Polarisru/multiservo/HW/ms_cover.FCStd

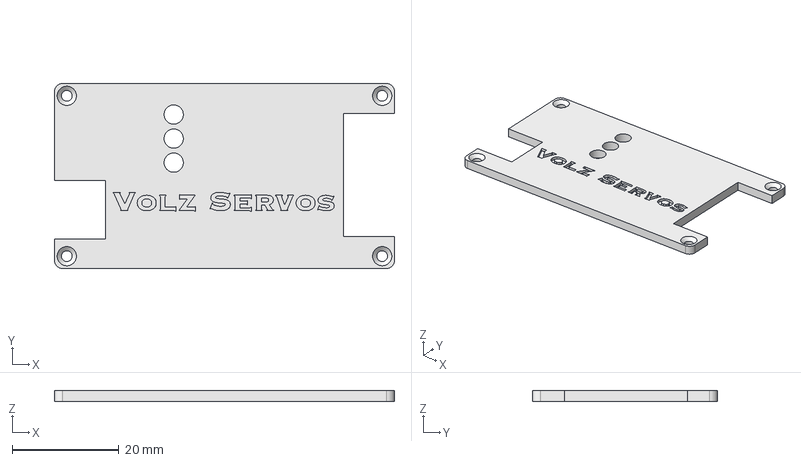
[picture p1: CAD file, 2021-03-29]
HW/ms_cover.FCStd
63.6 x 34.6 x 2.00 mm
