Polarisru/multiservo/HW/ms_bottom_bt.FCStd

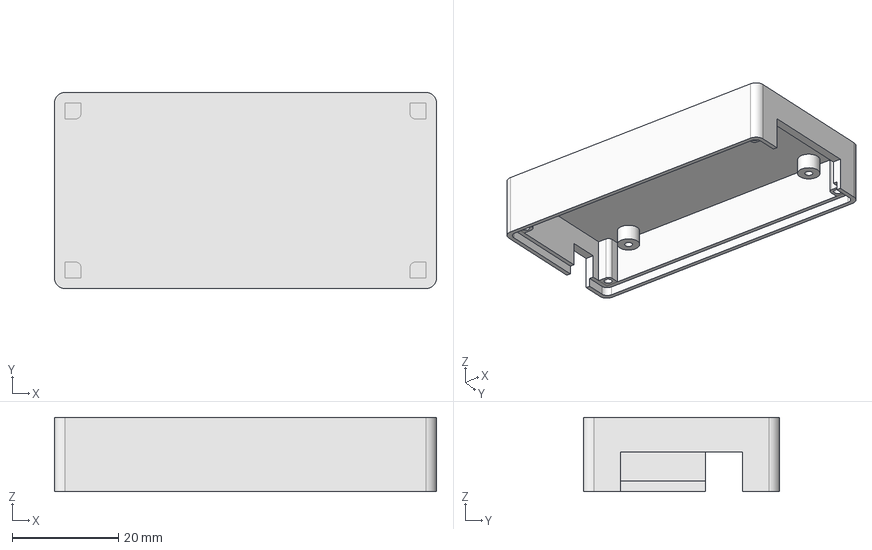
[picture p2: CAD file, 2021-03-03]
HW/ms_bottom_bt.FCStd
72.0 x 37.0 x 14.0 mm
