Polarisru/multiservo/HW/ms_cover_bt.FCStd

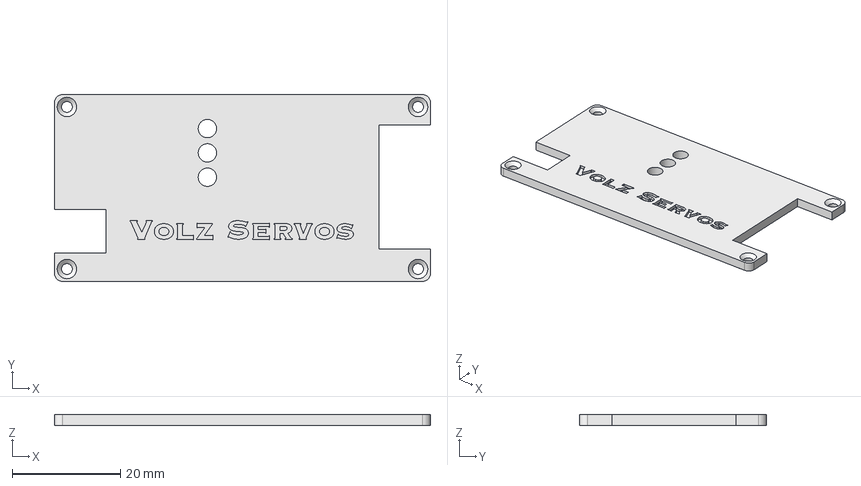
[picture p3: CAD file, 2021-03-03]
HW/ms_cover_bt.FCStd
69.6 x 34.6 x 2.00 mm
