Polarisru/multiservo/HW/ms_bottom.FCStd

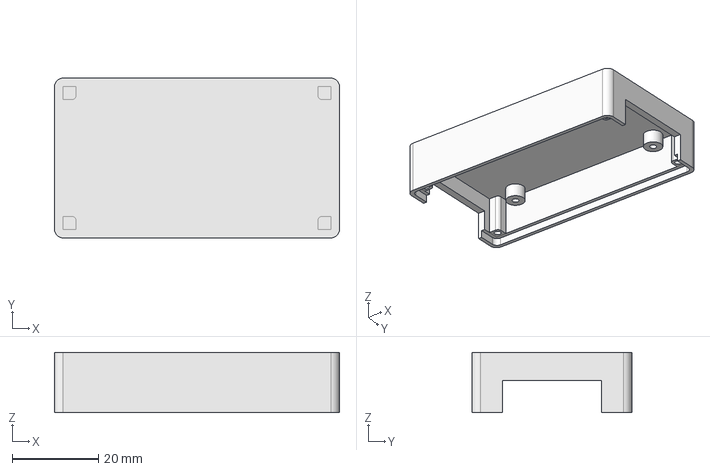
[picture p4: CAD file, 2021-02-24]
HW/ms_bottom.FCStd
66.0 x 37.0 x 14.0 mm
