Polarisru/multiservo/PCB/V3/MultiServo.pdf

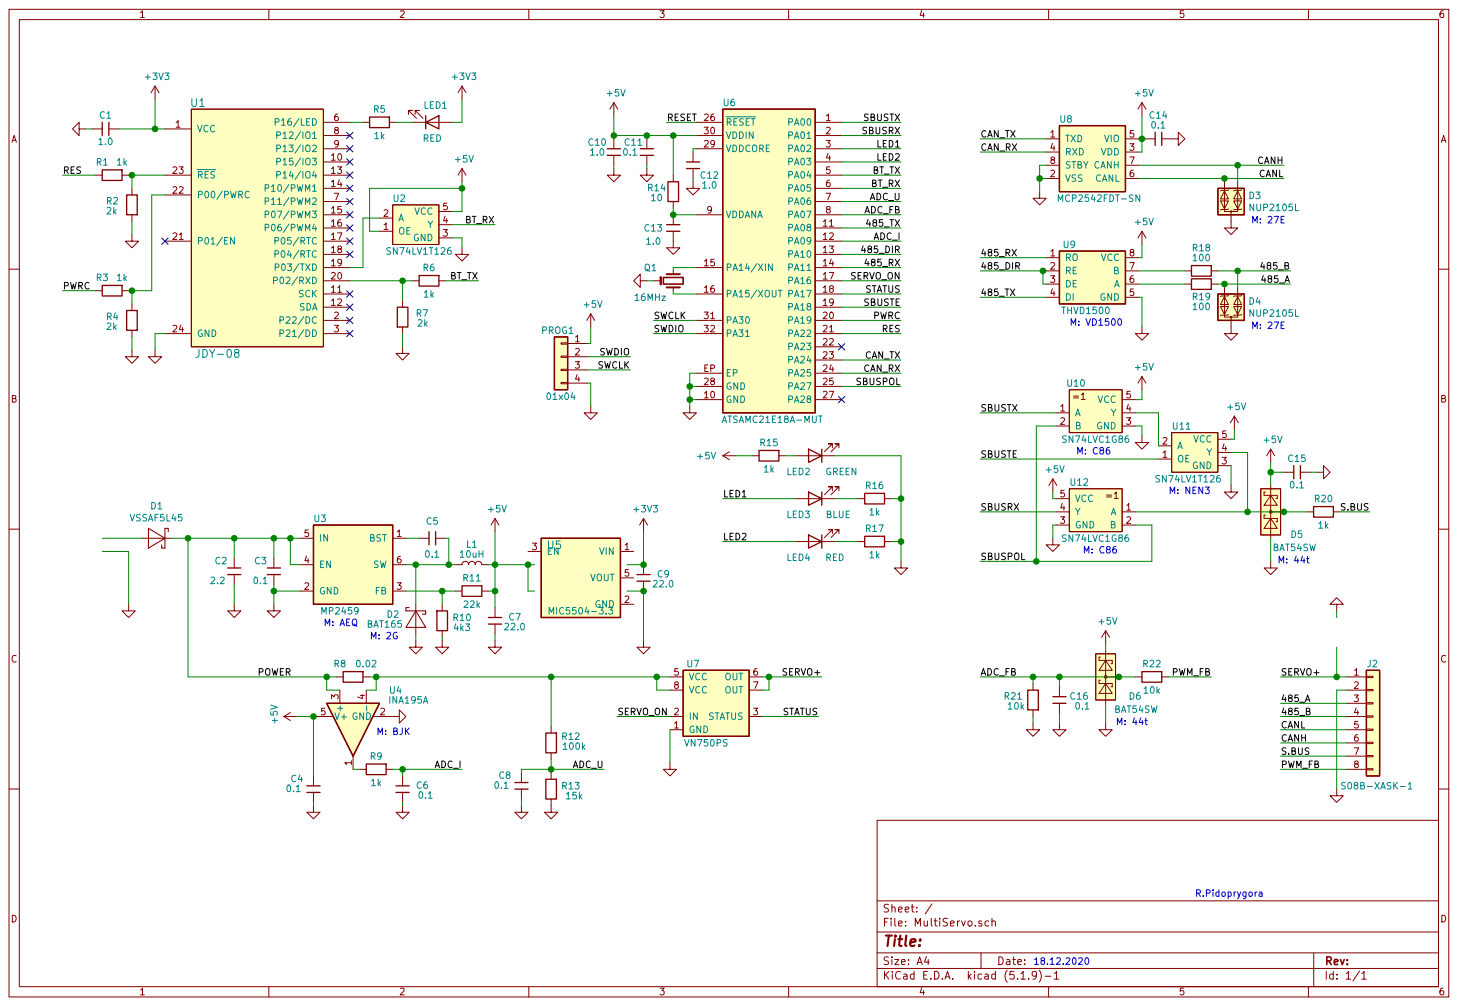
[picture p5: page 1]

Id: 1/1 Title: File: MultiServo.sch Sheet: /
