Polarisru/multiservo/PCB/MultiServo.pdf

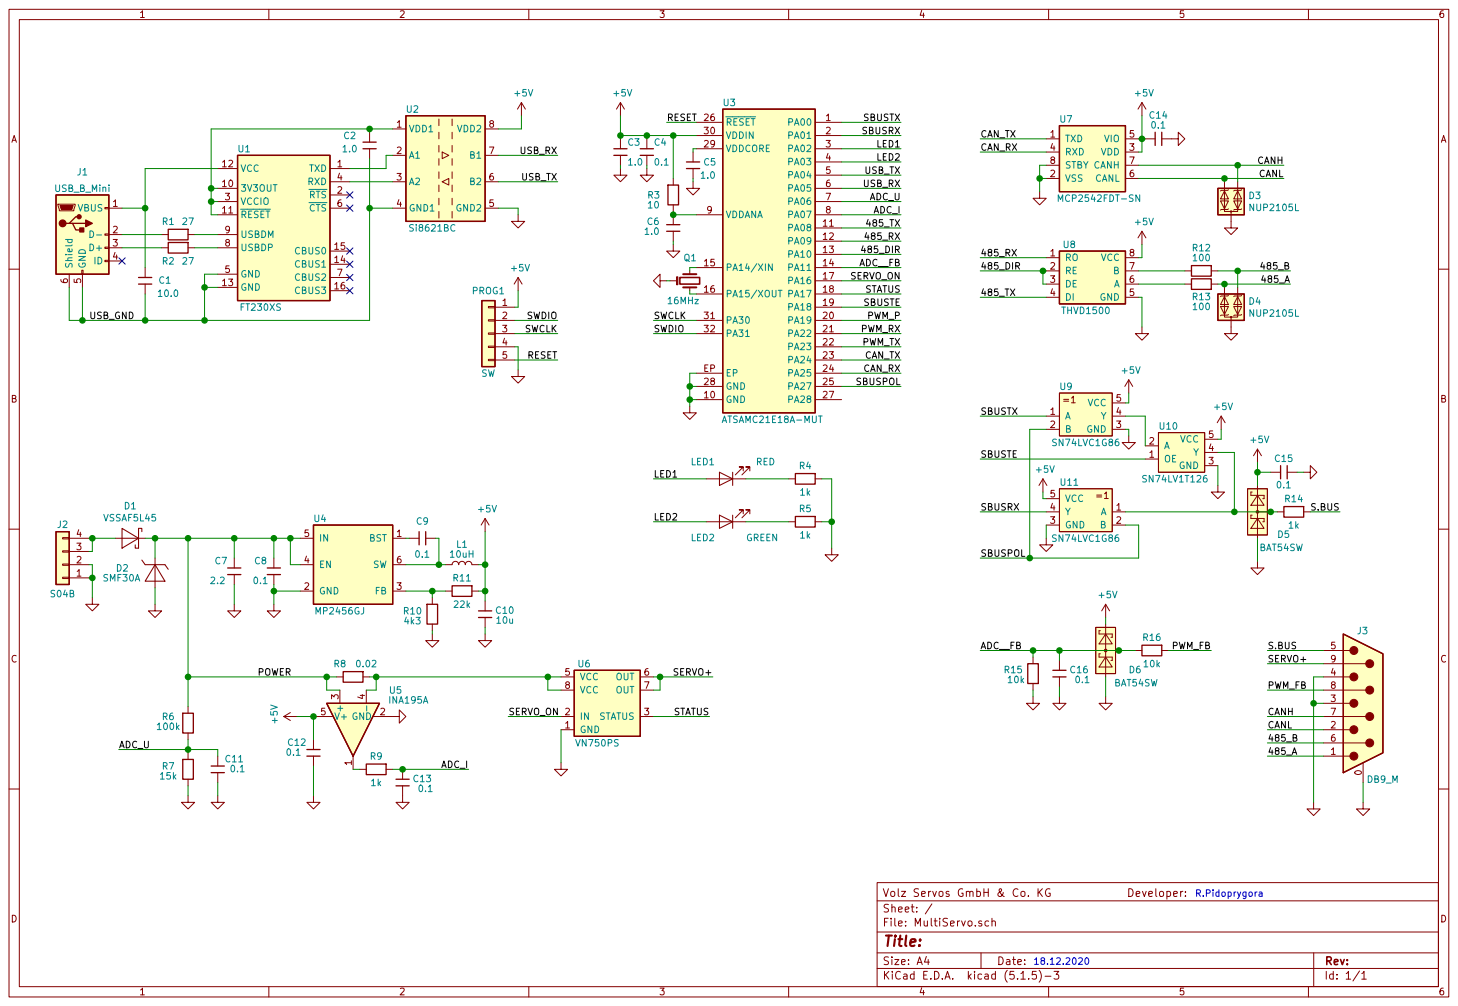
[picture p6: page 1]
