Polarisru/multiservo/PCB/V2/MultiServo.pdf

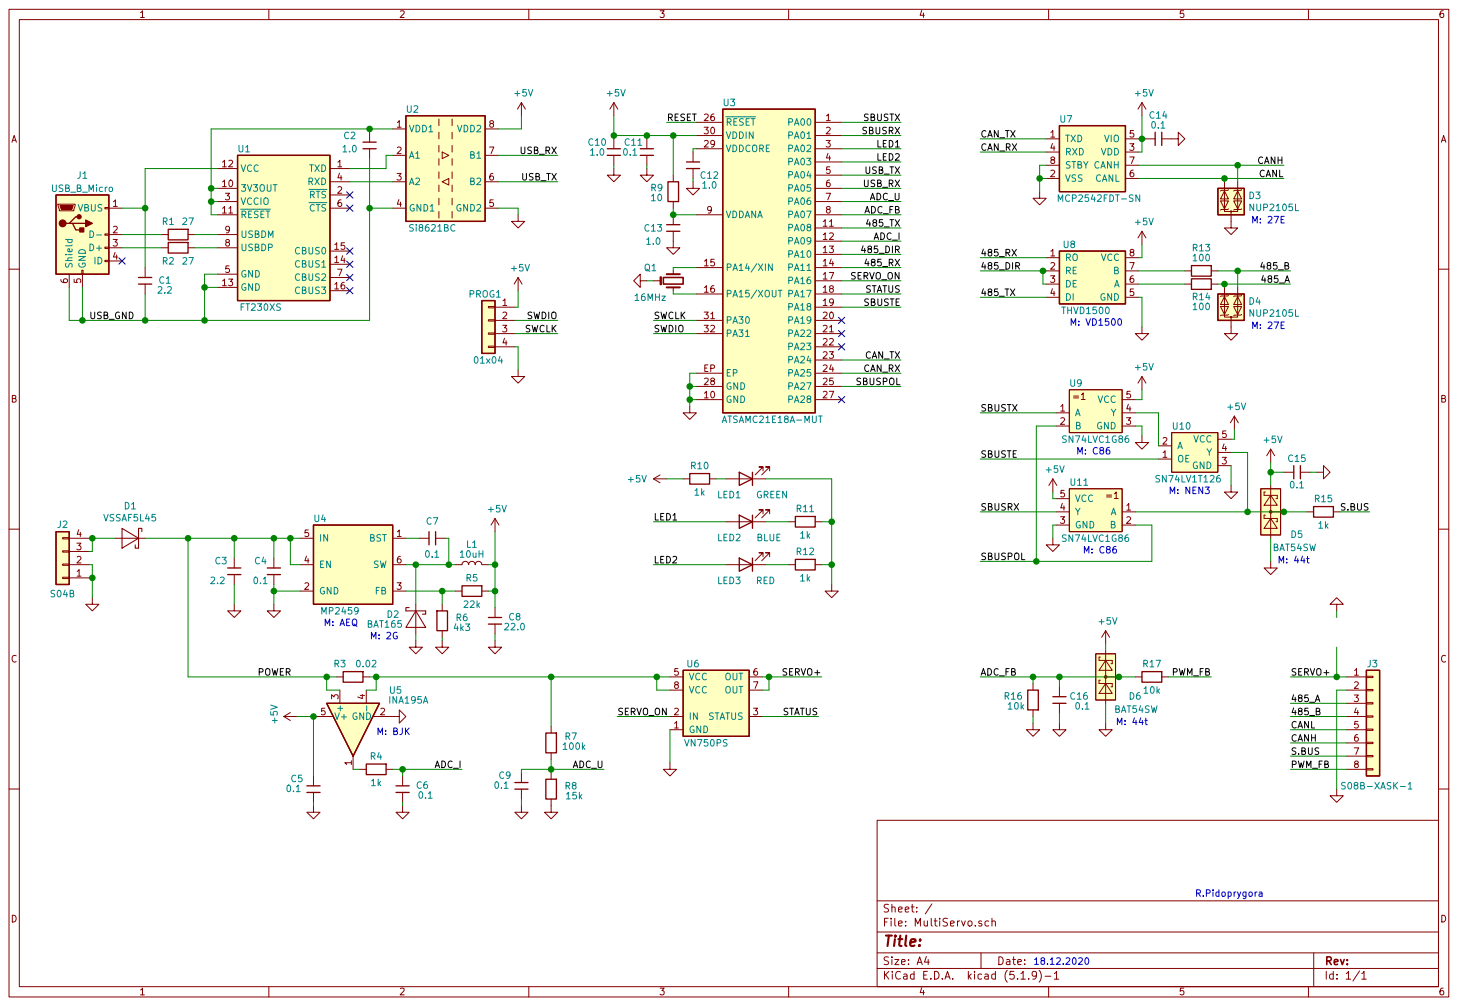
[picture p7: page 1]

Id: 1/1 Title: File: MultiServo.sch Sheet: / R11
