Polarisru/multiservo/PCB/V3/MultiServo.kicad_pcb

## KiCad design PCB/V3/MultiServo.kicad_pcb (2021-01-31)

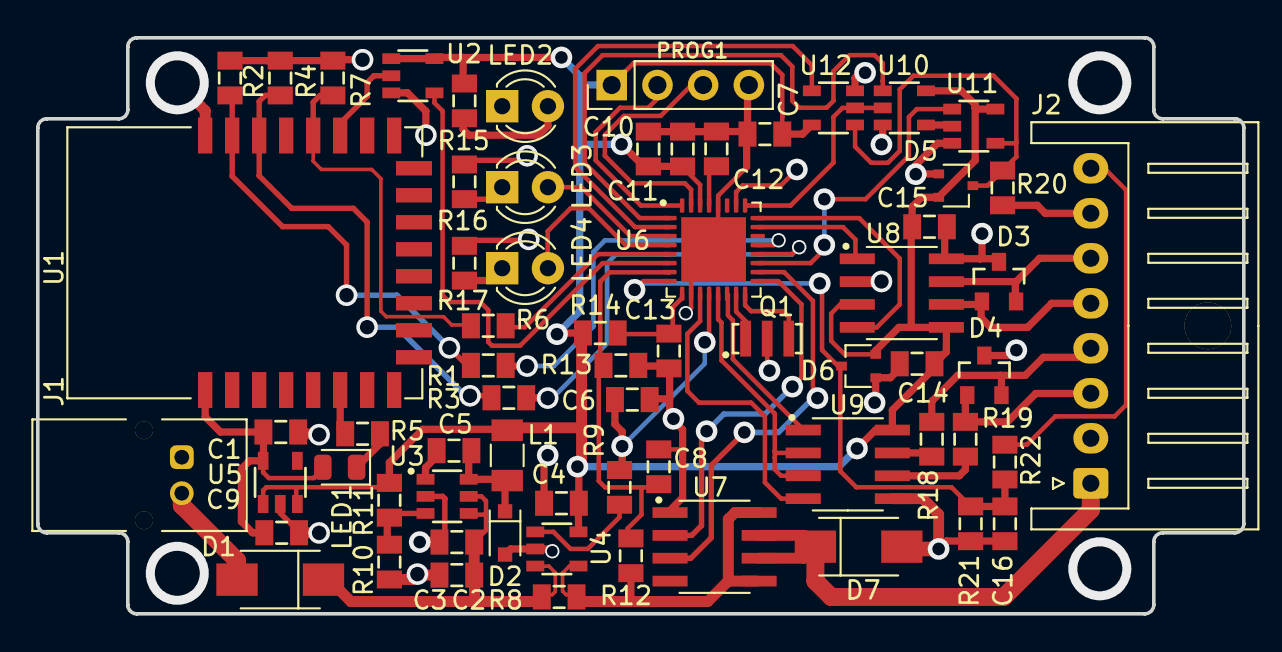
[picture p8: board PCB/V3/MultiServo.kicad_pcb from above]

Board: 2 copper layers, 67.0 x 32.0 mm, 66 parts (0 on the bottom side), 56 nets.

Parts:
C1, C10, C12, C13: 1.0; C0805
C2: 2.2; C0805
C3, C4, C5, C6, C8, C11, C14, C15, C16: 0.1; C0805
C7, C9: 22.0; C0805
D1: VSSAF5L45; D_SMA
D2: BAT165; D_SOD-323
D3, D4: NUP2105L; SOT23-3
D5, D6: BAT54SW; SOT-323_SC-70
D7: SMA6F30A; D_SMA
J1: JST_S02B_PASK; JST_S02B-PASK-2LFSN_1x02
J2: S08B-XASK-1; JST_XA_S08B-XASK-1x08_P2.50mm_Horizontal
L1: 10uH; L_1206
LED1: RED; LED_0805_2012Metric
LED2: GREEN; LED_D3.0mm
LED3: BLUE; LED_D3.0mm
LED4: RED; LED_D3.0mm
PROG1: 01x04; PinHeader_1x04_P2.54mm_Vertical
Q1: 16MHz; RES-3
R1, R3, R5, R6, R9, R15, R16, R17, R20: 1k; R0805
R2, R4, R7: 2k; R0805
R8: 0.02; R0805
R10: 4k3; R0805
R11: 22k; R0805
R12: 100k; R0805
R13: 15k; R0805
R14: 10; R0805
R18, R19: 100; R0805
R21, R22: 10k; R0805
U1: JDY-08
U2, U11: SN74LV1T126; SOT23-5
U3: MP2459; SOT23-6
U4: INA195A; SOT23-5
U5: MIC5504-3.3; SOT23-5
U6: ATSAMC21E18A-MUT; QFN-32-1EP_5x5mm_P0.5mm_EP3.6x3.6mm
U7: VN750PS; SOIC-8_3.9x4.9mm_P1.27mm
U8: MCP2542FDT-SN; SOIC-8_3.9x4.9mm_P1.27mm
U9: THVD1500; SOIC-8_3.9x4.9mm_P1.27mm
U10, U12: SN74LVC1G86; SOT23-5

Connections:
+3V3: C1.1, C9.2, LED1.2, U1.1, U5.5
+5V: C4.2, C7.2, C10.1, C11.1, C14.1, C15.1, D5.2, D6.2, L1.2, PROG1.1, R11.1, R14.2, R15.2, U2.1, U2.5, U4.5, U5.1, U5.3, U6.30, U8.3, U8.5, U9.8, U10.5, U11.5, U12.5
/485_A: D4.1, J2.3, R19.1
/485_B: D4.2, J2.4, R18.1
/485_DIR: U6.13, U9.2, U9.3
/485_RX: U6.14, U9.1
/485_TX: U6.11, U9.4
/ADC_FB: C16.2, D6.3, R21.2, R22.2, U6.8
/ADC_I: C6.2, R9.1, U6.12
/ADC_U: C8.2, R12.2, R13.1, U6.7
/BT_RX: U2.4, U6.6
/BT_TX: R6.1, U6.5
/CANH: D3.2, J2.6, U8.7
/CANL: D3.1, J2.5, U8.6
/CAN_RX: U6.24, U8.4
/CAN_TX: U6.23, U8.1
/LED1: LED3.2, U6.3
/LED2: LED4.2, U6.4
/POWER: C2.2, C3.2, D1.1, R8.2, U3.4, U3.5, U4.3
/PWM_FB: J2.8, R22.1
/PWRC: R3.2, U6.20
/RES: R1.2, U6.21
/S.BUS: J2.7, R20.1
/SBUSPOL: U6.25, U10.2, U12.2
/SBUSRX: U6.2, U12.4
/SBUSTE: U6.19, U11.1
/SBUSTX: U6.1, U10.1
/SERVO+: D7.1, J2.1, U7.6, U7.7
/SERVO_ON: U6.17, U7.2
/STATUS: U6.18, U7.3
/SWCLK: PROG1.3, U6.31
/SWDIO: PROG1.2, U6.32
GND: C1.2, C2.1, C3.1, C4.1, C6.1, C7.1, C8.1, C9.1, C10.2, C11.2, C12.2, C13.2, C14.2, C15.2, C16.1, D2.2, D3.3, D4.3, D5.1, D6.1, D7.2, J1.1, J2.2, LED2.1, PROG1.4, Q1.2, R2.1, R4.1, R7.1, R10.2, R13.2, R16.1, R17.1, R21.1, U1.24, U2.3, U3.2, U4.2, U5.2, U6.10, U6.28, U6.EP, U7.1, U8.2, U8.8, U9.5, U10.3, U11.3, U12.3
unnamed: C5.1, U3.1
unnamed: C5.2, D2.1, L1.1, U3.6
unnamed: C12.1, U6.29
unnamed: C13.1, R14.1, U6.9
unnamed: D1.2, J1.2
unnamed: D5.3, R20.2, U11.4, U12.1
unnamed: LED1.1, R5.1
unnamed: LED2.2, R15.1
unnamed: LED3.1, R16.2
unnamed: LED4.1, R17.2
unnamed: Q1.1, U6.15
unnamed: Q1.3, U6.16
unnamed: R1.1, R2.2, U1.23
unnamed: R3.1, R4.2, U1.22
unnamed: R5.2, U1.6
unnamed: R6.2, R7.2, U1.20
unnamed: R9.2, U4.1
unnamed: R10.1, R11.2, U3.3
unnamed: R8.1, R12.1, U4.4, U7.5, U7.8
unnamed: R18.2, U9.7
unnamed: R19.2, U9.6
unnamed: U1.19, U2.2
unnamed: U10.4, U11.2
