Polarisru/multiservo/PCB/V2/MultiServo.kicad_pcb

## KiCad design PCB/V2/MultiServo.kicad_pcb (2021-01-31, an earlier design)

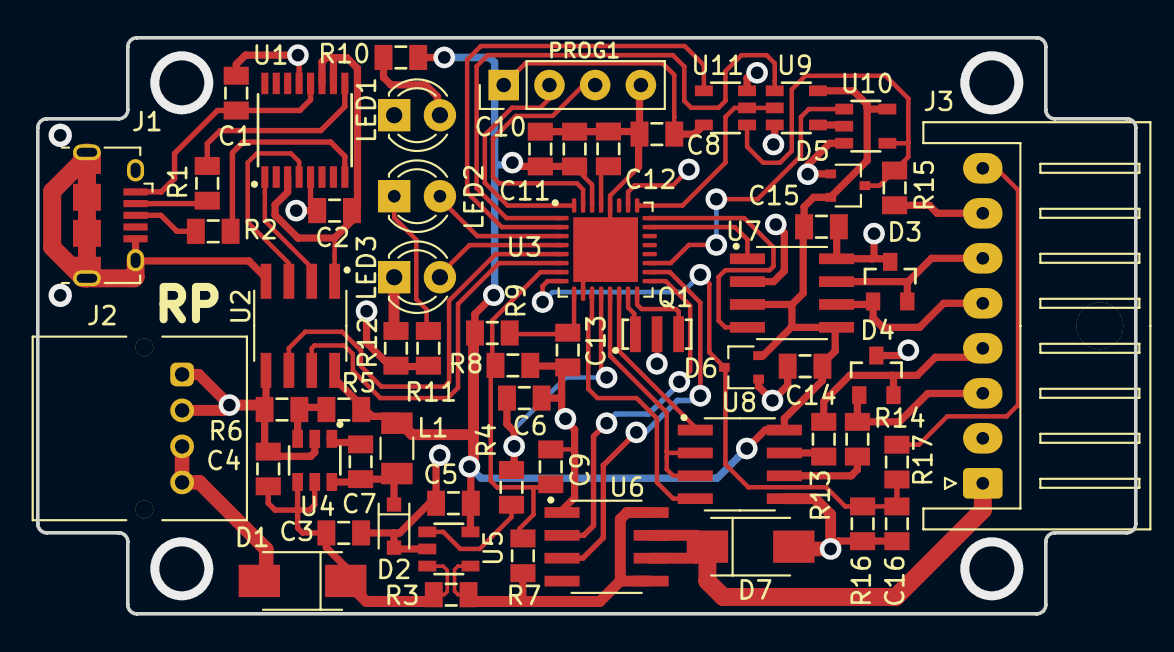
[picture p9: board PCB/V2/MultiServo.kicad_pcb from above]

Board: 2 copper layers, 61.0 x 32.0 mm, 60 parts (0 on the bottom side), 56 nets.

Parts:
C1, C3: 2.2; C0805
C2, C10, C12, C13: 1.0; C0805
C4, C5, C6, C7, C9, C11, C14, C15, C16: 0.1; C0805
C8: 22.0; C0805
D1: VSSAF5L45; D_SMA
D2: BAT165; D_SOD-323
D3, D4: NUP2105L; SOT23-3
D5, D6: BAT54SW; SOT-323_SC-70
D7: SMA6F30A; D_SMA
J1: USB_B_Micro; USB_Micro-B_Amphenol_10118194_Horizontal
J2: S04B; JST_S04B-PASK-2LFSN_1x04
J3: S08B-XASK-1; JST_XA_S08B-XASK-1x08_P2.50mm_Horizontal
L1: 10uH; L_1206
LED1: GREEN; LED_D3.0mm
LED2: BLUE; LED_D3.0mm
LED3: RED; LED_D3.0mm
PROG1: 01x04; PinHeader_1x04_P2.54mm_Vertical
Q1: 16MHz; RES-3
R1, R2: 27; R0805
R3: 0.02; R0805
R4, R10, R11, R12, R15: 1k; R0805
R5: 22k; R0805
R6: 4k3; R0805
R7: 100k; R0805
R8: 15k; R0805
R9: 10; R0805
R13, R14: 100; R0805
R16, R17: 10k; R0805
U1: FT230XS; SSOP-16_3.9x4.9mm_P0.635mm
U2: Si8621BC; SOIC-8_3.9x4.9mm_P1.27mm
U3: ATSAMC21E18A-MUT; QFN-32-1EP_5x5mm_P0.5mm_EP3.6x3.6mm
U4: MP2459; SOT23-6
U5: INA195A; SOT23-5
U6: VN750PS; SOIC-8_3.9x4.9mm_P1.27mm
U7: MCP2542FDT-SN; SOIC-8_3.9x4.9mm_P1.27mm
U8: THVD1500; SOIC-8_3.9x4.9mm_P1.27mm
U9, U11: SN74LVC1G86; SOT23-5
U10: SN74LV1T126; SOT23-5

Connections:
+5V: C5.2, C8.2, C10.1, C11.1, C14.1, C15.1, D5.2, D6.2, L1.2, PROG1.1, R5.1, R9.2, R10.2, U2.8, U3.30, U5.5, U7.3, U7.5, U8.8, U9.5, U10.5, U11.5
/485_A: D4.1, J3.3, R14.1
/485_B: D4.2, J3.4, R13.1
/485_DIR: U3.13, U8.2, U8.3
/485_RX: U3.14, U8.1
/485_TX: U3.11, U8.4
/ADC_FB: C16.2, D6.3, R16.2, R17.2, U3.8
/ADC_I: C6.2, R4.1, U3.12
/ADC_U: C9.2, R7.2, R8.1, U3.7
/CANH: D3.2, J3.6, U7.7
/CANL: D3.1, J3.5, U7.6
/CAN_RX: U3.24, U7.4
/CAN_TX: U3.23, U7.1
/LED1: LED2.2, U3.3
/LED2: LED3.2, U3.4
/POWER: C3.2, C4.2, D1.1, R3.2, U4.4, U4.5, U5.3
/PWM_FB: J3.8, R17.1
/S.BUS: J3.7, R15.1
/SBUSPOL: U3.25, U9.2, U11.2
/SBUSRX: U3.2, U11.4
/SBUSTE: U3.19, U10.1
/SBUSTX: U3.1, U9.1
/SERVO+: D7.1, J3.1, U6.6, U6.7
/SERVO_ON: U3.17, U6.2
/STATUS: U3.18, U6.3
/SWCLK: PROG1.3, U3.31
/SWDIO: PROG1.2, U3.32
/USB_GND: C1.1, C2.2, J1.5, J1.6, U1.5, U1.13, U2.4
/USB_RX: U2.7, U3.6
/USB_TX: U2.6, U3.5
GND: C3.1, C4.1, C5.1, C6.1, C8.1, C9.1, C10.2, C11.2, C12.2, C13.2, C14.2, C15.2, C16.1, D2.2, D3.3, D4.3, D5.1, D6.1, D7.2, J2.1, J2.2, J3.2, LED1.1, PROG1.4, Q1.2, R6.2, R8.2, R11.1, R12.1, R16.1, U2.5, U3.10, U3.28, U3.EP, U4.2, U5.2, U6.1, U7.2, U7.8, U8.5, U9.3, U10.3, U11.3
unnamed: C1.2, J1.1, U1.12
unnamed: C2.1, U1.3, U1.10, U1.11, U2.1
unnamed: C7.1, U4.1
unnamed: C7.2, D2.1, L1.1, U4.6
unnamed: C12.1, U3.29
unnamed: C13.1, R9.1, U3.9
unnamed: D1.2, J2.3, J2.4
unnamed: D5.3, R15.2, U10.4, U11.1
unnamed: J1.2, R1.2
unnamed: J1.3, R2.2
unnamed: LED1.2, R10.1
unnamed: LED2.1, R11.2
unnamed: LED3.1, R12.2
unnamed: Q1.1, U3.15
unnamed: Q1.3, U3.16
unnamed: R1.1, U1.9
unnamed: R2.1, U1.8
unnamed: R3.1, R7.1, U5.4, U6.5, U6.8
unnamed: R4.2, U5.1
unnamed: R5.2, R6.1, U4.3
unnamed: R13.2, U8.7
unnamed: R14.2, U8.6
unnamed: U1.1, U2.2
unnamed: U1.4, U2.3
unnamed: U9.4, U10.2
