Polarisru/multiservo/FW/src/drivers.h

#ifndef DRIVERS_H
#define DRIVERS_H

#ifndef DEF_UNITTEST
  #include "driver_adc.h"
  #include "driver_can.h"
  #include "driver_clk.h"
  #include "driver_dma.h"
  #include "driver_flash.h"
  #include "driver_gpio.h"
  #include "driver_pwm.h"
  #include "driver_temp.h"
  #include "driver_uart.h"
  #include "driver_vref.h"
  #include "driver_wdt.h"
#endif

#endif
