Polarisru/multiservo/FW/src/actions.c

#include "actions.h"
#include "analog.h"
#include "canbus.h"
#include "canbus_volz.h"
#include "canbus_amazon.h"
#include "canbus_meteor.h"
#include "conversion.h"
#include "global.h"
#include "keeloq.h"
#include "pwmout.h"
#include "rs485comm.h"
#include "sbus.h"

/** \brief Move servo to position
 *
 * \param [in] pos Position to move
 * \return True if action succeed
 *
 */
bool ACTIONS_MoveToPosition(float pos)
{
  bool res = true;

  switch (GLOBAL_ConnMode)
  {
    case CONN_MODE_PWM:
      PWMOUT_SetValue(pos);
      break;
    case CONN_MODE_RS485:
      res = RS485COMM_SetPosition(pos);
      break;
    case CONN_MODE_CAN:
      res = CANBUS_SetPosition(pos);
      break;
    case CONN_MODE_AMAZON:
      res = CANBUS_SetPositionAmazon(pos);
      break;
    case CONN_MODE_SBUS:
      res = SBUS_SetPosition(pos);
      break;
    case CONN_MODE_METEOR:
      return CANBUS_SetPositionMeteor(pos);
    default:
      return false;
  }

  if (res == true)
    /**< Start fast current measurement */
    ANALOG_StartDMA();
  return res;
}

bool ACTIONS_GetPosition(float *pos)
{
  switch (GLOBAL_ConnMode)
  {
    case CONN_MODE_PWM:
      /**< Get feedback voltage */
      *pos = CONVERSION_GetFeedbackPos();
      return true;
    case CONN_MODE_RS485:
      return RS485COMM_GetPosition(pos);
    case CONN_MODE_CAN:
      return CANBUS_GetPosition(pos);
    case CONN_MODE_AMAZON:
      return CANBUS_GetPositionAmazon(pos);
    case CONN_MODE_SBUS:
      break;
    case CONN_MODE_METEOR:
      return CANBUS_GetPositionMeteor(pos);
  }

  return false;
}

/** \brief Read byte from servo
 *
 * \param [in] addr Address to read from
 * \param [out] value Pointer fo readout value
 * \return True if succeed
 *
 */
bool ACTIONS_ReadByte(uint16_t addr, uint8_t *value)
{
  switch (GLOBAL_ConnMode)
  {
    case CONN_MODE_PWM:
      return KEELOQ_Read(addr, value);
    case CONN_MODE_RS485:
      return RS485COMM_ReadByte(addr, value);
    case CONN_MODE_CAN:
      return CANBUS_ReadByte(addr, value);
    case CONN_MODE_AMAZON:
      break;
    case CONN_MODE_SBUS:
      break;
    case CONN_MODE_METEOR:
      return CANBUS_ReadByteMeteor(addr, value);
  }

  return false;
}

bool ACTIONS_WriteByte(uint16_t addr, uint8_t value)
{
  switch (GLOBAL_ConnMode)
  {
    case CONN_MODE_PWM:
      return KEELOQ_Write(addr, value);
    case CONN_MODE_RS485:
      return RS485COMM_WriteByte(addr, value);
    case CONN_MODE_CAN:
      return CANBUS_WriteByte(addr, value);
    case CONN_MODE_AMAZON:
      break;
    case CONN_MODE_SBUS:
      break;
    case CONN_MODE_METEOR:
      return CANBUS_WriteByteMeteor(addr, value);
  }

  return false;
}

/** \brief Read device parameter
 *
 * \param param Id of the parameter
 * \param val Pointer to uint8_t to store result
 * \return True if success
 *
 */
bool ACTION_ReadParameter(uint8_t param, uint8_t *val)
{
  uint8_t temp;
  bool result;

  if (param >= ACTION_PARAM_LAST)
    return false;

  switch (GLOBAL_ConnMode)
  {
    case CONN_MODE_PWM:
      switch (param)
      {
        case ACTION_PARAM_CURRENT:
          temp = KEELOQ_ADDR_CURRENT;
          break;
        case ACTION_PARAM_VOLTAGE:
          temp = KEELOQ_ADDR_VOLTAGE;
          break;
        case ACTION_PARAM_TEMPERATURE:
          temp = KEELOQ_ADDR_TEMP;
          break;
        default:
          return false;
      }
      //PWM_DisableChannel(PWM_CH1);
      result = KEELOQ_Read(temp, val);
      //PWM_EnableChannel(PWM_CH1);
      if (*val == 0xff)
        return false;
      return result;

    case CONN_MODE_RS485:
      switch (param)
      {
        case ACTION_PARAM_CURRENT:
          return RS485COMM_GetCurrent(val);
        case ACTION_PARAM_VOLTAGE:
          return RS485COMM_GetVoltage(val);
        case ACTION_PARAM_TEMPERATURE:
          return RS485COMM_GetTemperature(val);
      }

    case CONN_MODE_CAN:
      switch (param)
      {
        case ACTION_PARAM_CURRENT:
          return CANBUS_GetCurrent(val);
        case ACTION_PARAM_VOLTAGE:
          return CANBUS_GetVoltage(val);
        case ACTION_PARAM_TEMPERATURE:
          return CANBUS_GetTemperature(val);
      }

    case CONN_MODE_AMAZON:
      switch (param)
      {
        case ACTION_PARAM_CURRENT:
          return CANBUS_GetCurrentAmazon(val);
        case ACTION_PARAM_VOLTAGE:
          return CANBUS_GetVoltageAmazon(val);
        case ACTION_PARAM_TEMPERATURE:
          return CANBUS_GetTemperatureAmazon(val);
          break;
      }
      return true;
  }

  return false;
}

/** \brief Set bus ID for selected protocol
 *
 * \param id ID to set
 * \return True if success
 *
 */
bool ACTIONS_SetId(uint8_t id)
{
  switch (GLOBAL_ConnMode)
  {
    case CONN_MODE_PWM:
      return false;
    case CONN_MODE_RS485:
      return true;
    case CONN_MODE_CAN:
      return CANBUS_SetId(id);
    case CONN_MODE_AMAZON:
      return true;
    case CONN_MODE_UAVCAN_0:
      return true;
    case CONN_MODE_SBUS:
      return true;
      break;
    case CONN_MODE_METEOR:
      return true;
    default:
      return false;
  }
}

/** \brief Set working mode (PWM/RS485/CAN/SBUS)
 *
 * \param [in] mode Working mode
 * \return True if succeed
 *
 */
bool ACTIONS_SetMode(uint8_t mode)
{
  if (mode >= CONN_MODE_LAST)
    return false;

  PWMOUT_Disable();
  SBUS_Disable();

  GLOBAL_ConnMode = mode;
  switch (mode)
  {
    case CONN_MODE_PWM:
      PWMOUT_Enable();
      break;
    case CONN_MODE_RS485:
      /**< Do nothing, is always working */
      break;
    case CONN_MODE_CAN:
      break;
    case CONN_MODE_AMAZON:
      break;
    case CONN_MODE_UAVCAN_0:
      /**< Have to start Node allocation server here */
      break;
    case CONN_MODE_SBUS:
      SBUS_Enable();
      break;
    case CONN_MODE_METEOR:
      break;
  }

  return true;
}
