Polarisru/multiservo/FW/src/canbus.c

#include <string.h>
#include "canbus.h"
#include "defines.h"
#include "global.h"

#define CAN_PORT            GPIO_PORTA
#define CAN_PIN_RX          25
#define CAN_PIN_TX          24

#define CAN_MUX_RX          MUX_PA25G_CAN0_RX
#define CAN_MUX_TX          MUX_PA24G_CAN0_TX

#define CAN_CHANNEL         CAN0
#define CAN_INTHANDLER      CAN0_Handler
#define CAN_IRQ             CAN0_IRQn

///**< The queue is to be created to hold a maximum of 10 uint64_t variables */
//#define CAN_QUEUE_LENGTH    10
//#define CAN_ITEM_SIZE       sizeof(TCanMsg)
//
//QueueHandle_t xQueueCAN;

TCanMsg rxMsg;

/**< CAN interrupt handler */
void CAN_INTHANDLER(void)
{
  uint32_t ir;
  BaseType_t xHigherPriorityTaskWoken = pdFALSE;

  ir = CAN_CHANNEL->IR.reg;

  if (ir & CAN_IR_RF0N)
  {
    struct can_message msg;
    uint8_t data[64];

    msg.data = data;
    CAN_ReadMsg(CAN_CHANNEL, &msg);
    rxMsg.id = msg.id;
    rxMsg.fmt = msg.fmt;
    rxMsg.len = msg.len;
    memcpy(rxMsg.data, msg.data, msg.len);
    //xQueueSendFromISR(xQueueCAN, &CanMsg, &xHigherPriorityTaskWoken);
    xEventGroupSetBitsFromISR(xEventGroupCommon, EG_BIT_CAN_RX, &xHigherPriorityTaskWoken);
  }

	CAN_CHANNEL->IR.reg = ir;

  /**< Now the buffer is empty we can switch context if necessary */
  portYIELD_FROM_ISR(xHigherPriorityTaskWoken);
}

/** \brief Send one CAN message
 *
 * \param [in] msg Pointer to CANFDMessage to send
 * \param [in] ext Extended CAN ID: true
 * \param [in] fd  CANFD message: true
 * \param [in] brs Message with baudrate switching: true
 * \return True if succeed
 *
 */
bool CANBUS_SendMessage(uint32_t id, uint8_t *data, uint8_t datalen, bool ext, bool fd, bool brs)
{
  struct can_message msg;

  msg.id = id;
  msg.type = CAN_TYPE_DATA;
  msg.data = data;
  msg.len = datalen;
  if (ext == true)
    msg.fmt  = CAN_FMT_EXTID;
  else
    msg.fmt = CAN_FMT_STDID;
  if (fd == true)
    msg.type = CAN_TYPE_FD;
  else
    msg.type = CAN_TYPE_DATA;
  if (brs == true)
    msg.type = CAN_TYPE_FD_BRS;
  return (CAN_WriteMsg(CAN_CHANNEL, &msg) == ERR_NONE);
}

/** \brief Receive one message from CAN bus
 *
 * \param [out] msg Pointer to received CANFDMessage
 * \return True if succeed
 *
 */
bool CANBUS_ReceiveMessage(TCanMsg *msg)
{
  EventBits_t uxBits = 0;

  uxBits = xEventGroupWaitBits(xEventGroupCommon, EG_BIT_CAN_RX, pdTRUE, pdFALSE, 1);
  if ((uxBits & EG_BIT_CAN_RX) == EG_BIT_CAN_RX)
  {
    memcpy(msg, &rxMsg, sizeof(TCanMsg));
    return true;
  }

  return false;
}

/** \brief Set CAN baudrate
 *
 * \param [in] nominal_br New nominal baudrate value
 * \param [in] data_br New data baudrate value (CAN FD only)
 * \return bool True if succeed
 *
 */
bool CANBUS_SetBaudrate(uint32_t nominal_br, uint32_t data_br)
{
  return CAN_SetBaudrate(CAN_CHANNEL, nominal_br, data_br);
}

/** \brief Deinitialize CAN module
 *
 * \return Nothing
 *
 */
void CANBUS_Disable(void)
{
  CAN_Disable(CAN_CHANNEL);
}

/** \brief Initialize CAN communication module
 *
 * \return Nothing
 *
 */
void CANBUS_Configuration(void)
{
  CAN_Init(CAN_CHANNEL);

  /**< Enable CAN interrupt */
  NVIC_DisableIRQ(CAN_IRQ);
  NVIC_ClearPendingIRQ(CAN_IRQ);
  NVIC_EnableIRQ(CAN_IRQ);
  CAN_CHANNEL->ILE.reg = CAN_ILE_EINT0;

  /**< Configure CAN pins */
  /**< There is only one available pin configuration for this MCU */
  GPIO_SetFunction(CAN_PORT, CAN_PIN_TX, CAN_MUX_TX);
  GPIO_SetFunction(CAN_PORT, CAN_PIN_RX, CAN_MUX_RX);

  /**< Setup CAN filters */
	//CAN_SetRangeFilter(0, CAN_FMT_EXTID, CANBUS_NOC_FILTER, CANBUS_NOC_FILTER + CANBUS_SERVO_MAX_ID);
	//CAN_SetRangeFilter(1, CAN_FMT_EXTID, CANBUS_TMC_FILTER, CANBUS_TMC_FILTER + CANBUS_SERVO_MAX_ID);
	CAN_SetRangeFilter(0, CAN_FMT_STDID, 0x000, 0x7ff);

	CAN_Enable(CAN_CHANNEL);
}
