Polarisru/multiservo/FW/src/analog.h

#ifndef ADC_H
#define ADC_H

#include "defines.h"

#define ADC_REF_VOLTAGE     4.096f

#define ADC_MAX_VALUE       4096

#define FB_VOLTAGE_ZERO     2.5f

enum {
  ADC_CHANNEL_U,
  ADC_CHANNEL_FB,
  ADC_CHANNEL_I,
  ADC_CHANNEL_NUM
};

typedef struct {
  uint8_t port;
  uint8_t pin;
  uint8_t pin_mode;
  uint8_t channel;
} TAnalogChannel;

uint16_t ANALOG_GetValueADC0(uint8_t channel);
uint16_t ANALOG_GetValueADC1(uint8_t channel, uint8_t type);
void ANALOG_StartDMA(void);
uint16_t ANALOG_GetSpikeValue(void);
bool ANALOG_GetBuff(uint32_t num, uint8_t *data);
void ANALOG_FillFftBuff(int8_t *data, uint16_t len);
void ANALOG_Configuration(void);

#endif
