Polarisru/multiservo/FW/src/global.c

#include "global.h"

/**< List of global variables */
uint32_t GLOBAL_Baudrate;
uint8_t  GLOBAL_ConnMode;
float    GLOBAL_PeakCurrent;
bool     GLOBAL_PowerOn;

/**< EEPROM variables with default values */
int16_t  EE_CurrOffset;
float    EE_VoltSupplyDiv;

TaskHandle_t xTaskComm;
TaskHandle_t xTaskSbus;

EventGroupHandle_t xEventGroupCommon;
