Polarisru/multiservo/FW/src/utils.c

#include <ctype.h>
#include <string.h>
#include "utils.h"

/** \brief Make string value for the binary number
 *
 * \param [in] value Integer value to convert to binary string
 * \param [in] len Length of binary number
 * \return String with binary value
 *
 */
const char *UTILS_Int2Bin(uint32_t value, uint8_t len)
{
  static char b[32];
  uint32_t z;
  uint8_t i;

  b[0] = '\0';
  z = 1;

  for (i = 0; i < len; i++)
  {
    strcat(b, ((value & z) == z) ? "1" : "0");
    z <<= 1;
  }

  return b;
}

/** \brief Return median value for 3 values
 *
 * \param [in] a, b, c Word values to calculate
 * \return Median value, word
 *
 */
uint16_t UTILS_Median3Filter(uint16_t a, uint16_t b, uint16_t c)
{
  uint8_t Temp = 0;

  if (a>b)
    Temp += 4;
  if (a>c)
    Temp += 2;
  if (b>c)
    Temp += 1;

  switch (Temp)
  {
    case 0:
    case 7:
      return b;
    case 3:
    case 4:
      return a;
    default:
      return c;
  }
}

/** \brief Convert string to upper case
 *
 * \param [in] Input string
 * \return Output string
 *
 */
char *UTILS_StrUpr(char *s)
{
  char *str = s;

  while (*str)
  {
    *str = toupper(*str);
    str++;
  }
  return s;
}

/** \brief Convert byte to HEX string
 *
 * \param [in] byte Value to convert
 * \return HEX string
 *
 */
char *UTILS_ToHex(uint8_t byte)
{
  static char str[3];

  if ((byte>>4)>9)
    str[0] = (byte>>4) - 10 + 'A';
  else
    str[0] = (byte>>4) + '0';
  if ((byte&0x0F)>9)
    str[1] = (byte&0x0F) - 10 + 'A';
  else
    str[1] = (byte&0x0F) + '0';
  str[2] = 0;

  return str;
}
