Polarisru/multiservo/(commit log)

2020-12-22 KeeLoq is not working yet
    [keeloq.c, keeloq.h]
2020-12-22 Schematics is new
    [MultiServo.kicad_pcb, MultiServo.sch]
2020-12-23 PWM is working, Analog module started, outputs working, communication working
2020-12-28 RS485 servo is supported EEPROM settings are working Bootloader is working
2020-12-31 KeeLoq is working now CAN is also working
    [MultiServo.kicad_pcb, MultiServo.sch]
2021-01-01 3D models added Supply voltage and current calibration are working Problem with voltage measurement fixed Updater is working
    [ms_bottom.FCStd, ms_cover.FCStd]
2021-01-02 Connection, position, readout of U/I/t° is working ToDo: Read parameters, check for bugs
    [__main__.py, comm.py]
2021-01-18 feat: Channels for ADC added, current is ADC1 now
    [ms_bottom.FCStd]
2021-01-19 ADC DMA added Drivers moved to drivers.h
2021-01-22 PCBs added for both USB and BT
    [MultiServo.kicad_pcb, MultiServo.sch]
2021-01-31 Futaba is working now, but additional thread is needed. Fast analog channel with DMA is working now. Some new HW files added.
    [MultiServo.kicad_pcb]
2021-02-01 Current graph readout added (GBx) Graph added to pyvisio
2021-02-02 FFT added to current graph
2021-02-03 SBUS has own task and transferred via DMA
2021-02-04 Libcanard added Full SBUS support now Problem with ADC0 solved, but needs to be cleared
    [__main__.py, actions.c, defines.h, driver_adc.c, driver_dma.c, parser.c, sbus.c]
2021-02-16 - Meteor protocol started - UAVCAN v0 files added - PWM frequency is 100Hz now - FFT added, but not working properly
    [__main__.py, actions.c, analog.c, analog.h, canbus.c, canbus_meteor.c, canbus_meteor.h, canbus_volz.c]
2021-02-24 3d model for bottom changed for new PCB
    [ms_bottom.FCStd]
2021-02-24 3d model for new PCB added
2021-02-24 3d model for cover added for new PCB
    [ms_cover.FCStd]
2021-02-28 HW: Cover changed to fix LEDs position
    [ms_cover.FCStd]
2021-03-02 FW: - Added name to JDY-08 HW: - Bottom for MS_BT prepared
    [ms_bottom_bt.FCStd]
2021-03-03 FW: - Bluetooth set name processing improved - Another LED is blinking now (blue)
2021-03-03 HW: - Bluetooth bottom and cover added for 3D-printing
    [ms_bottom_bt.FCStd, ms_cover.FCStd, ms_cover_bt.FCStd]
2021-03-20 FW: - serial channel module added (PWM bootloader) - bootloader changed - new CAN protocol must work now - SID command added to set ID for bus communication
2021-03-29 FW: - PWM/RS485/CAN bootloader is working - Some bugs fixed in communication protocols for bootloader HW: - LEDs size increased for cover
    [ms_cover.FCStd]
